Galile0-designs/Qwail56/README.md

# qwail56
A split ergonomic mechanical keyboard based on Lily58, crkbd and Sofle.
