Galile0-designs/Qwail56/qwail56 v1/case files/Case.stl

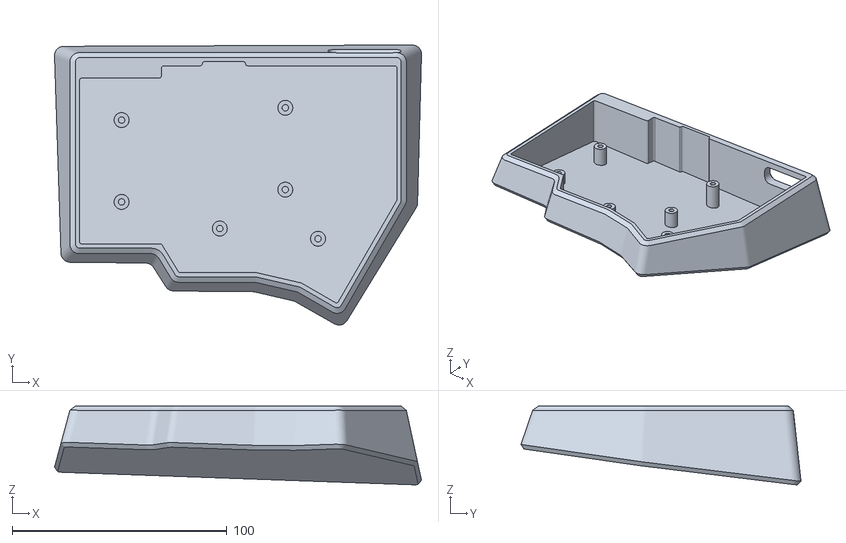
[picture p1: CAD file, 2023-08-10]
qwail56 v1/case files/Case.stl
170.8 x 130.3 x 36.6
