Galile0-designs/Qwail56/qwail56 v1/pcb/Pico-R3 v4.step

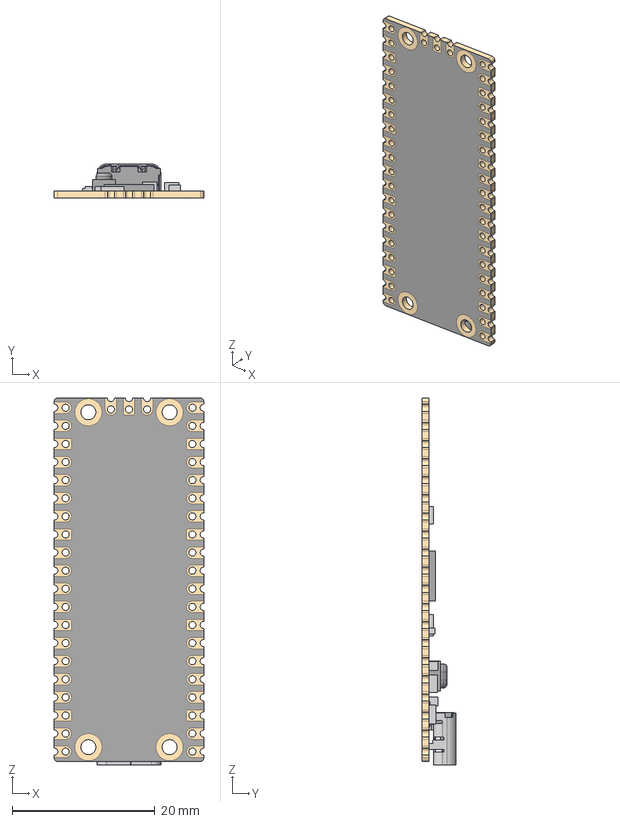
[picture p2: CAD file, 2023-07-06]
qwail56 v1/pcb/Pico-R3 v4.step
21.0 x 4.76 x 51.5 mm
PICO_REF_BOARD.STEP
PICO_REF_SWITCH.STEP
PICO_REF_MICROCONTROLLER.STEP
PICO_REF_LED.STEP
PICO_REF_ONSEMI.STEP
PICO_BOURNS.STEP
PICO_MURATA.STEP x 2
PICO_RICHTEK.STEP
PICO_DIODES.STEP
PICO_AEL.STEP
PICO_WINBOND.STEP
USB4105-15-A-120_PART2
USB4105-15-A-120_PART1
