Galile0-designs/Qwail56/qwail56 v1/case files/Plate.stl

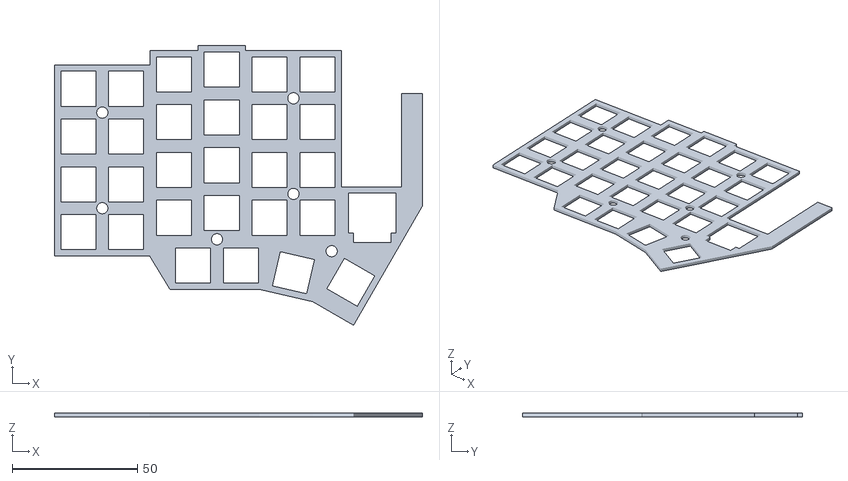
[picture p3: CAD file, 2023-08-10]
qwail56 v1/case files/Plate.stl
146.7 x 111.4 x 1.50
