Galile0-designs/Qwail56/qwail56 v1/pcb/RotarryEncoder_EC12-SW.step

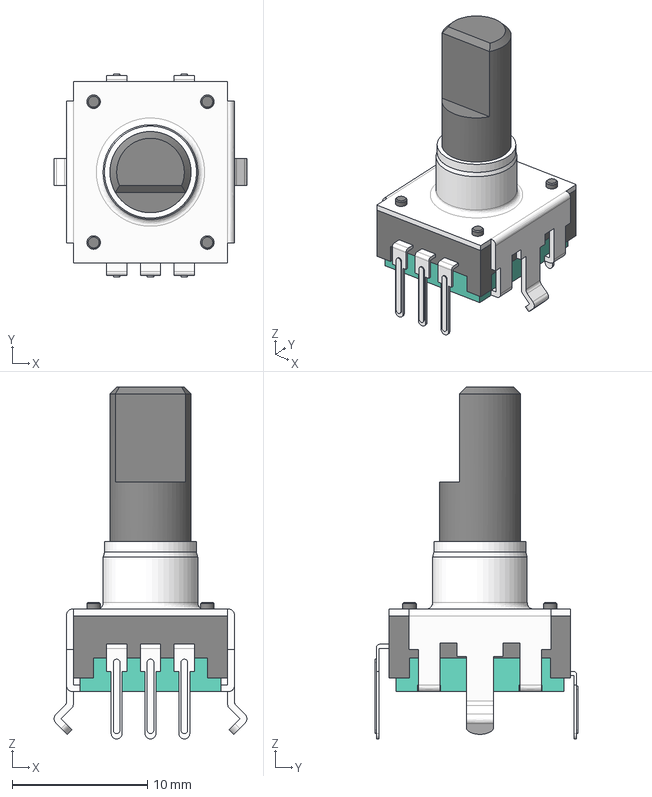
[picture p4: CAD file, 2023-07-03]
qwail56 v1/pcb/RotarryEncoder_EC12-SW.step
14.2 x 15.0 x 26.0 mm
