Galile0-designs/Qwail56/qwail56 v1/pcb/Kailh-CherryMX-Socket.step

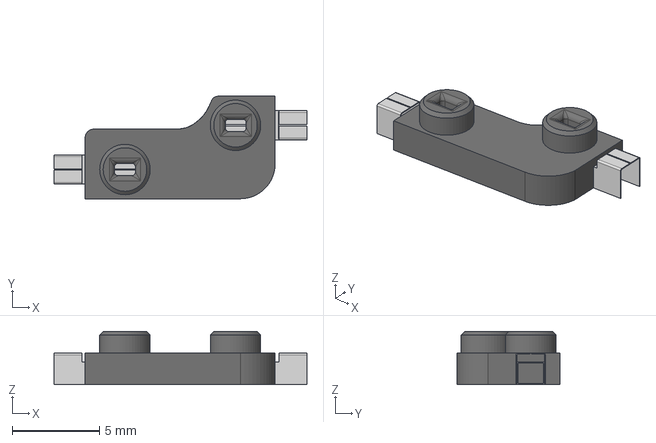
[picture p5: CAD file, 2023-07-02]
qwail56 v1/pcb/Kailh-CherryMX-Socket.step
14.5 x 5.89 x 3.05 mm
