Galile0-designs/Qwail56/qwail56 v1/pcb/PJ320A.step

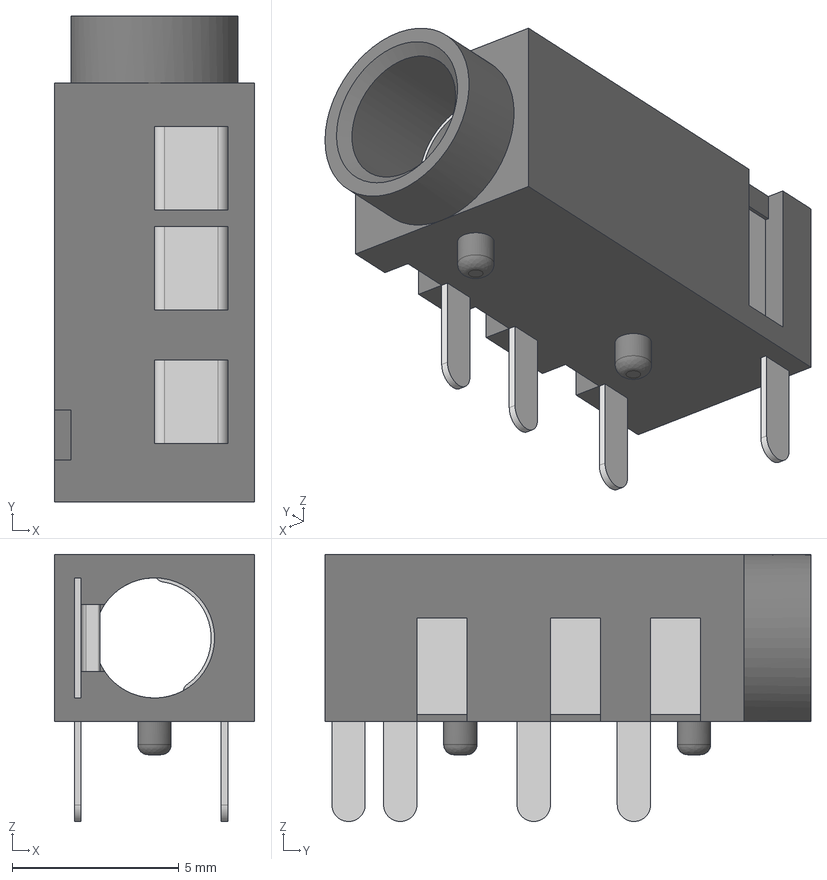
[picture p6: CAD file, 2023-07-02]
qwail56 v1/pcb/PJ320A.step
6.00 x 14.6 x 8.00 mm
