Galile0-designs/Qwail56/(list of files, cad)

Other CAD files:
qwail56 v1/case files/qwail56 v1.f3d
