Galile0-designs/Qwail56/qwail56 v1/pcb/qwail56.kicad_sch

## KiCad design qwail56 v1/pcb/qwail56.kicad_sch (2023-07-03)

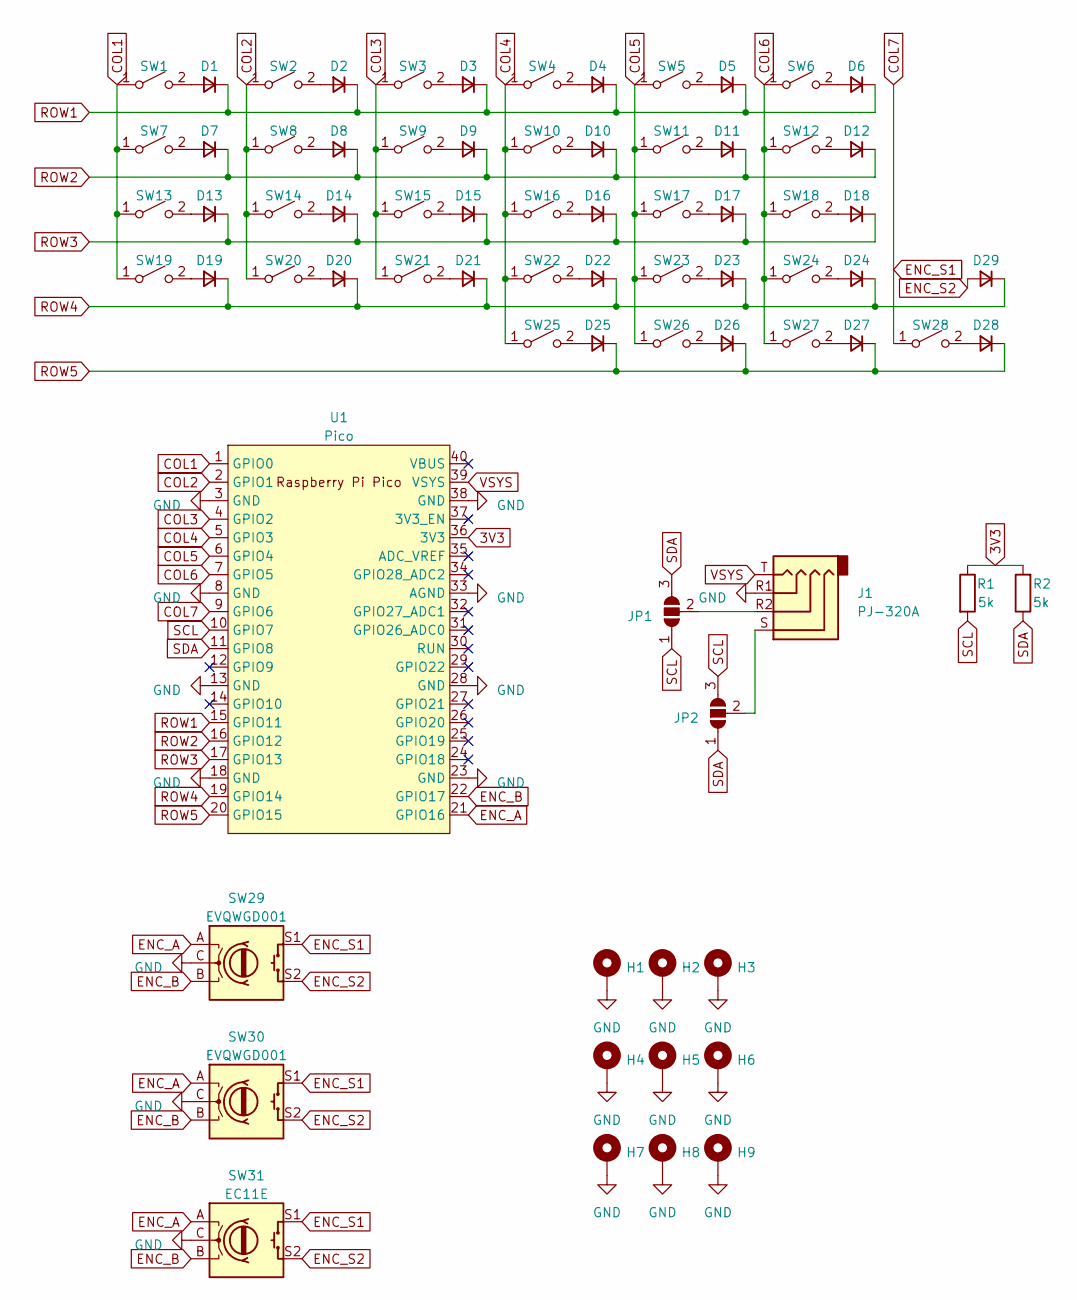
[picture p7: schematic qwail56.kicad_sch]

Parts:
D1, D2, D3, D4, D5, D6, D7, D8, D9, D10, D11, D12, D13, D14, D15, D16, D17, D18, D19, D20, D21, D22, D23, D24, D25, D26, D27, D28: 1N4148W; D_SOD-123_switch_reversible
D29: 1N4148W; D_SOD-123_reversible
H1, H2, H3, H4, H5, H6, H7, H8, H9: MountingHole; MountingHole_2.2mm_M2_Pad
J1: PJ-320A; Jack_3.5mm_PJ320A_reversible
JP1, JP2: SolderJumper; SolderJumper-3_P2.0mm_Open_TrianglePad1.0x1.5mm_NumberLabel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
R1, R2: 5k; R_1206_3216Metric_reversible
SW1, SW2, SW3, SW4, SW5, SW6, SW7, SW8, SW9, SW10, SW11, SW12, SW13, SW14, SW15, SW16, SW17, SW18, SW19, SW20, SW21, SW22, SW23, SW24, SW25, SW26, SW27: CPG151101S11-16; CherryMX_Hotswap_1u_reversible
SW28: CPG151101S11-16; CherryMX_Hotswap_1.5u_reversible
SW29, SW30: EVQWGD001; Encoder_Horizontal_EVQWGD001
SW31: EC11E; Rotary_Encoder_EC11E_reversible
U1: Pico; Pi_Pico_TH_reversible

Connections:
3V3: R1.1, R2.2, U1.36 (3V3)
COL1: SW1.1 (A), SW7.1 (A), SW13.1 (A), SW19.1 (A), U1.1 (GPIO0)
COL2: SW2.1 (A), SW8.1 (A), SW14.1 (A), SW20.1 (A), U1.2 (GPIO1)
COL3: SW3.1 (A), SW9.1 (A), SW15.1 (A), SW21.1 (A), U1.4 (GPIO2)
COL4: SW4.1 (A), SW10.1 (A), SW16.1 (A), SW22.1 (A), SW25.1 (A), U1.5 (GPIO3)
COL5: SW5.1 (A), SW11.1 (A), SW17.1 (A), SW23.1 (A), SW26.1 (A), U1.6 (GPIO4)
COL6: SW6.1 (A), SW12.1 (A), SW18.1 (A), SW24.1 (A), SW27.1 (A), U1.7 (GPIO5)
COL7: SW28.1 (A), SW29.S1, SW30.S1, SW31.S1, U1.9 (GPIO6)
ENC_A: SW29.A, SW30.A, SW31.A, U1.21 (GPIO16)
ENC_B: SW29.B, SW30.B, SW31.B, U1.22 (GPIO17)
ENC_S2: D29.2 (A), SW29.S2, SW30.S2, SW31.S2
GND: H1.1, H2.1, H3.1, H4.1, H5.1, H6.1, H7.1, H8.1, H9.1, J1.R1, SW29.C, SW30.C, SW31.C, U1.3 (GND), U1.8 (GND), U1.13 (GND), U1.18 (GND), U1.23 (GND), U1.28 (GND), U1.33 (AGND), U1.38 (GND)
unnamed: D1.2 (A), SW1.2 (B)
unnamed: D2.2 (A), SW2.2 (B)
unnamed: D3.2 (A), SW3.2 (B)
unnamed: D4.2 (A), SW4.2 (B)
unnamed: D5.2 (A), SW5.2 (B)
unnamed: D6.2 (A), SW6.2 (B)
unnamed: D7.2 (A), SW7.2 (B)
unnamed: D8.2 (A), SW8.2 (B)
unnamed: D9.2 (A), SW9.2 (B)
unnamed: D10.2 (A), SW10.2 (B)
unnamed: D11.2 (A), SW11.2 (B)
unnamed: D12.2 (A), SW12.2 (B)
unnamed: D13.2 (A), SW13.2 (B)
unnamed: D14.2 (A), SW14.2 (B)
unnamed: D15.2 (A), SW15.2 (B)
unnamed: D16.2 (A), SW16.2 (B)
unnamed: D17.2 (A), SW17.2 (B)
unnamed: D18.2 (A), SW18.2 (B)
unnamed: D19.2 (A), SW19.2 (B)
unnamed: D20.2 (A), SW20.2 (B)
unnamed: D21.2 (A), SW21.2 (B)
unnamed: D22.2 (A), SW22.2 (B)
unnamed: D23.2 (A), SW23.2 (B)
unnamed: D24.2 (A), SW24.2 (B)
unnamed: D25.2 (A), SW25.2 (B)
unnamed: D26.2 (A), SW26.2 (B)
unnamed: D27.2 (A), SW27.2 (B)
unnamed: D28.2 (A), SW28.2 (B)
unnamed: J1.R2, JP1.2 (C)
unnamed: J1.S, JP2.2 (C)
ROW1: D1.1 (K), D2.1 (K), D3.1 (K), D4.1 (K), D5.1 (K), D6.1 (K), U1.15 (GPIO11)
ROW2: D7.1 (K), D8.1 (K), D9.1 (K), D10.1 (K), D11.1 (K), D12.1 (K), U1.16 (GPIO12)
ROW3: D13.1 (K), D14.1 (K), D15.1 (K), D16.1 (K), D17.1 (K), D18.1 (K), U1.17 (GPIO13)
ROW4: D19.1 (K), D20.1 (K), D21.1 (K), D22.1 (K), D23.1 (K), D24.1 (K), D29.1 (K), U1.19 (GPIO14)
ROW5: D25.1 (K), D26.1 (K), D27.1 (K), D28.1 (K), U1.20 (GPIO15)
SCL: JP1.1 (A), JP2.3 (B), R1.2, U1.10 (GPIO7)
SDA: JP1.3 (B), JP2.1 (A), R2.1, U1.11 (GPIO8)
VSYS: J1.T, U1.39 (VSYS)
